coport-uni/SpinCoaterAutomation_I2C/claude_test/menu_cursor_check/runs/20261006_113356/frames/00_before.jpg

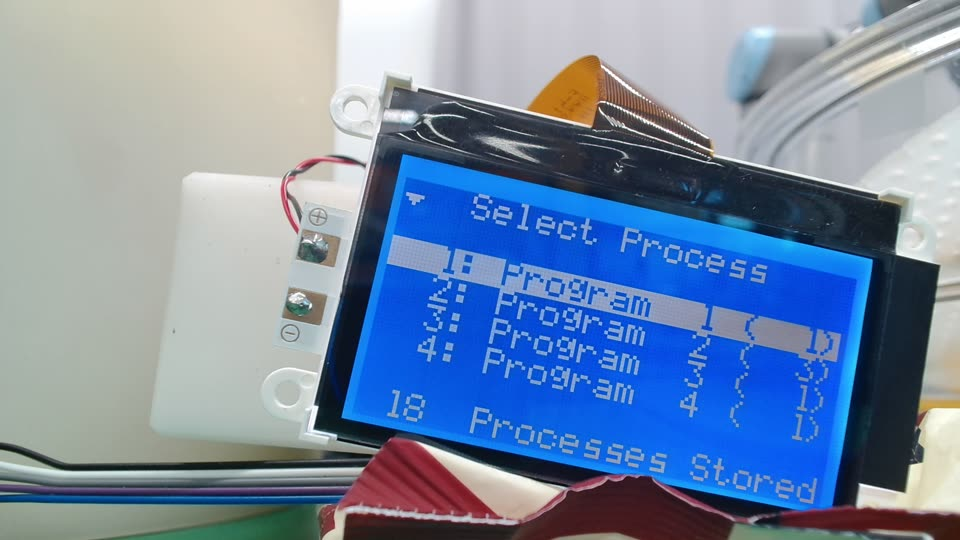
claude_test/menu_cursor_check/runs/20261006_113356/frames/00_before.jpg
