coport-uni/SpinCoaterAutomation_I2C/docs/ButtonLayout.jpg

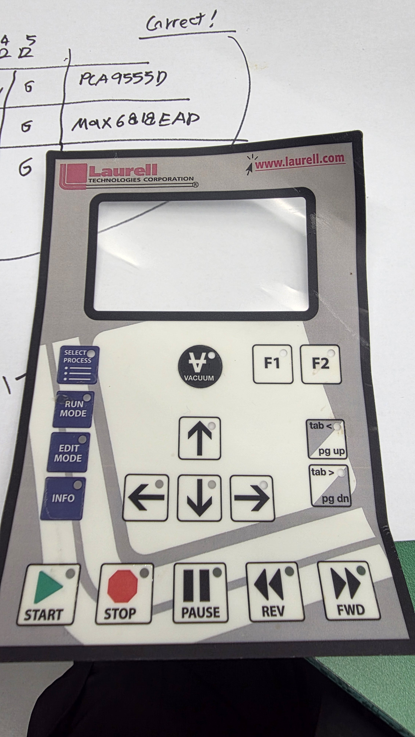
docs/ButtonLayout.jpg
