coport-uni/SpinCoaterAutomation_I2C/claude_test/KakaoTalk_20261006_142258731.jpg

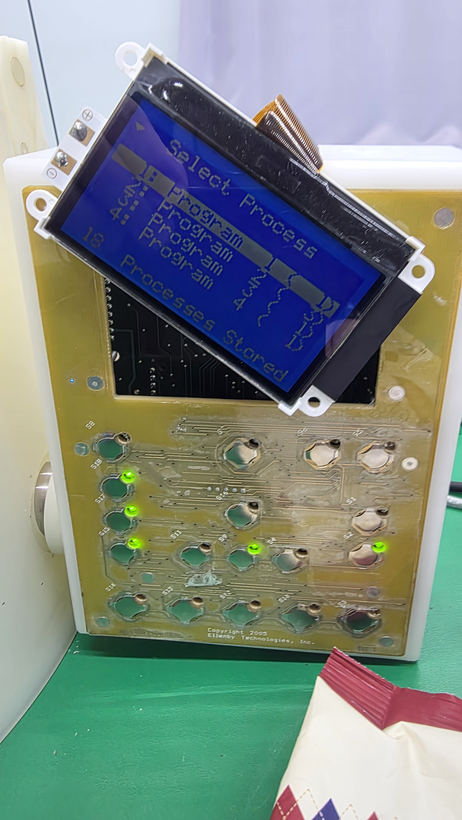
claude_test/KakaoTalk_20261006_142258731.jpg
