coport-uni/SpinCoaterAutomation_I2C/claude_test/lamp_trace/frames/00_before.jpg

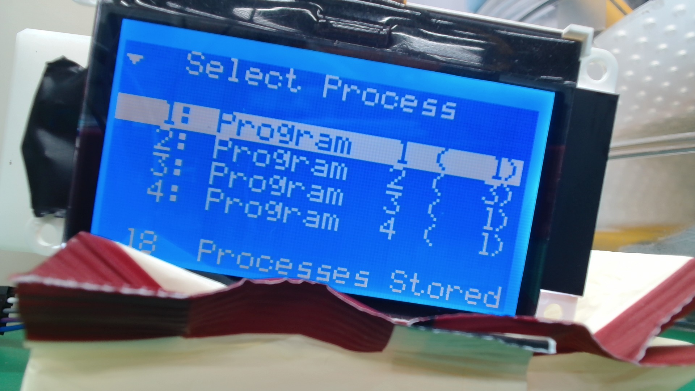
claude_test/lamp_trace/frames/00_before.jpg
