coport-uni/SpinCoaterAutomation_I2C/claude_test/led_only/invalid_run1_lcd.jpg

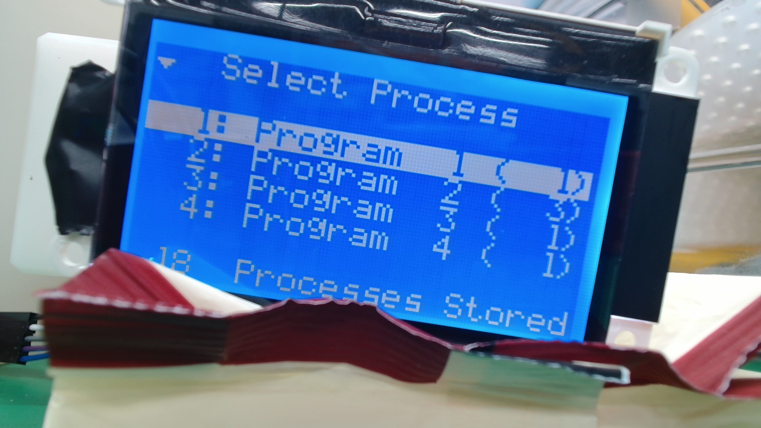
claude_test/led_only/invalid_run1_lcd.jpg
