coport-uni/SpinCoaterAutomation_I2C/claude_test/led_only/run3_lcd.jpg

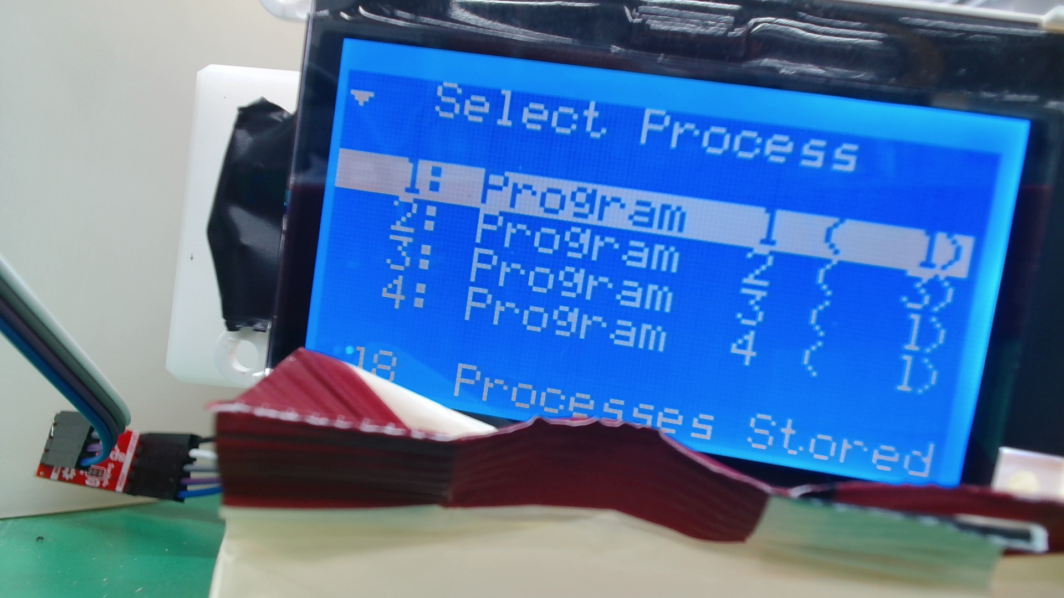
claude_test/led_only/run3_lcd.jpg
