coport-uni/SpinCoaterAutomation_I2C/claude_test/mk2_bench/frames/00_before.jpg

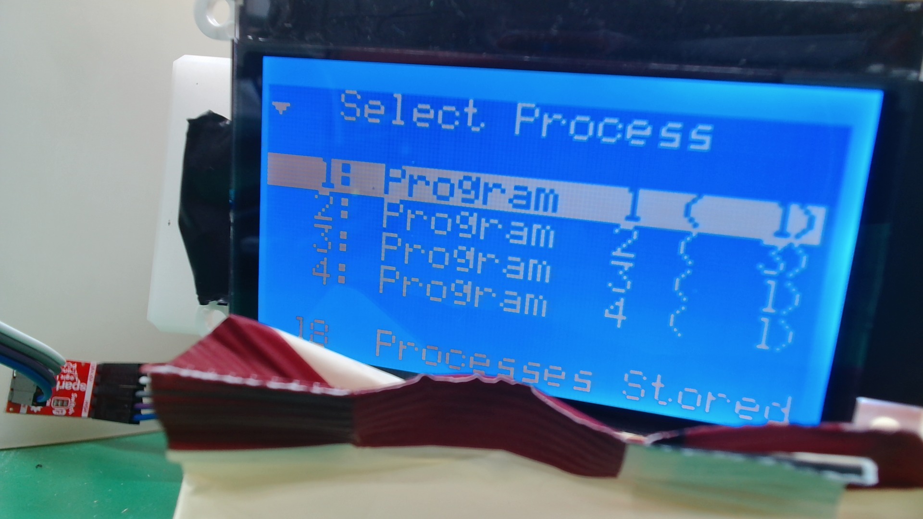
claude_test/mk2_bench/frames/00_before.jpg
