coport-uni/SpinCoaterAutomation_I2C/claude_test/mk2_bench/frames/01_after_DOWN.jpg

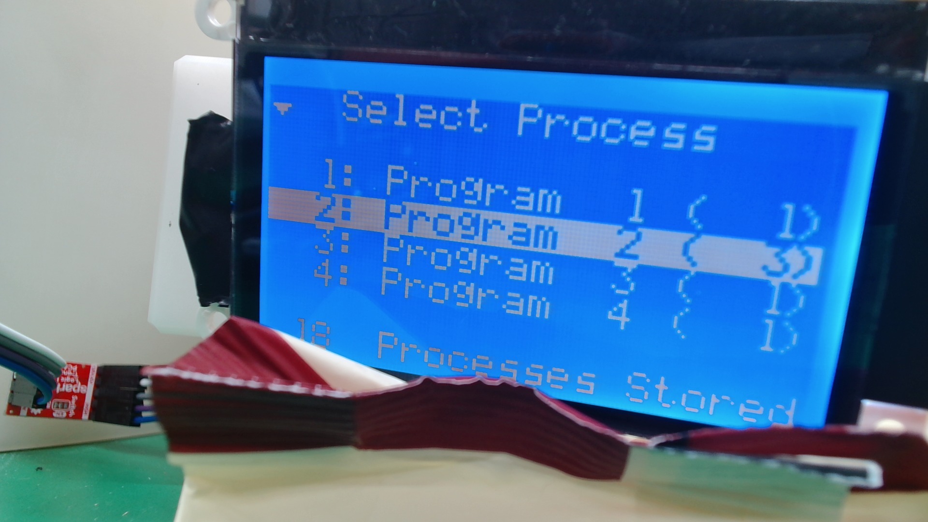
claude_test/mk2_bench/frames/01_after_DOWN.jpg
