coport-uni/SpinCoaterAutomation_I2C/(commit log)

2026-09-29 Map all 18 buttons and 16 LEDs of the keypad board
    Stage 1 of docs/spincoater_keypad_spec.md is complete. The keypad board
    was run standalone from the UNO Q 3.3 V rail and every button and LED
    was traced on real hardware.
    Findings:
    - Three slaves confirmed: PCA9555 at 0x21 and 0x22, PCA9532 at 0x60.
    - All 16 pins of 0x21 are buttons; 0x22 carries the other two.
    - PCA9532 channel n drives the LED of the button at 0x21 bit n, so
    button and LED share an index.
    - Header X1 pin 5 is INT, not RESET. It falls on any input change and
    returns high once the input register is read.
    - The 1 kOhm series resistor R16 on SCL does not break a 100 kHz bus.
    - The two LEDs the PCA9532 does not drive can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
    [i2c_scan.ino, keypad_probe.ino, pca9532_led.ino]
2026-09-29 feat(firmware): build the sketches for the R4 Minima too
    The spincoater mainboard I2C bus measured 5 V, so the 3.3 V UNO Q
    cannot be wired to it directly. Bench work moved to an UNO R4 Minima
    for a while, which needed both sketches to build for a board that has
    no Router Bridge.
    A HOST alias selected by ARDUINO_ARCH_ZEPHYR hides the difference: the
    UNO Q keeps talking through the Monitor object, every other board uses
    plain Serial over USB. host_begin() does the same for bring-up.
    i2c_scan also gained bus_check(), which samples SDA and SCL as plain
    GPIO before Wire takes the pins, in high impedance and again with the
    internal pull-up. That is what found the fault behind issue #3: the
    keypa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
    [bus_check.ino, i2c_scan.ino, pca9532_led.ino]
2026-09-29 chore(claude): adopt the CommonClaude harness
    Brings coport-uni/CommonClaude in as a submodule under external/ and
    wires its conventions and enforcement hooks into this repository, so
    that sessions follow one ruleset instead of an ad hoc one.
    The project CLAUDE.md imports the shared ruleset in full and then
    records the overrides this repository needs:
    - Arduino C++ conventions in place of the shared Python ones, keeping
    the 80-column limit, 4-space indent and Doxygen blocks.
    - Korean stays the language of prose documentation, since README.md,
    docs/ and claude_test/README.md are already written in it. Code
    comments, commit messages, issues and PRs stay English.
    - Ruff does not apply,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
2026-09-29 feat(claude_test): prove the UNO Q can act as an I2C target
    Spec section 8 carried "UNO Q Wire slave support unverified" as an open
    risk, and the whole stage 3 board choice hung on it. Two jumper wires
    settle it with no extra hardware.
    claude_test/slave_selftest opens Wire2 (i2c3, A4/A5) as a target at
    0x21 and drives the bus from Wire (i2c2, D20/D21) as a master, with
    A4 tied to D20 and A5 tied to D21. The keypad must be unplugged, since
    it answers at 0x21 itself; the scan line reports every address found so
    a stray 0x22 or 0x60 gives that away.
    The target answers its address, acknowledges a write, hands back the
    byte it was asked for, and fires both onReceive and onRequest. So the
    emulat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
2026-09-29 feat(claude_test): answer two I2C addresses from one controller
    Only two of the UNO Q's three I2C controllers reach the ordinary
    headers, and the emulator has to present three addresses: 0x21 and 0x22
    for the button expanders, 0x60 for the LED dimmer. The alternatives
    were breaking i2c4 out of the high density connector or dropping 0x60,
    and dropping 0x60 would cost the state feedback channel, since the
    mainboard's LED writes are what tell the host which keys are currently
    legal.
    Neither is necessary. The STM32 I2C peripheral has two own-address
    registers and the Zephyr driver mirrors them: struct i2c_stm32_data
    carries target_cfg and target2_cfg, the second behind
    CONFIG_I2C_STM32_V2, whic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
2026-09-29 test(claude_test): check both controllers hold two targets
    The previous run measured a pair of targets on i2c3 while i2c2 drove
    the bus, and the conclusion was stated as "two controllers times two
    addresses is four". That was arithmetic rather than a measurement:
    i2c2 had never been a target at all.
    TARGETS_ON_WIRE now picks which controller carries the pair, so both
    roles can be exercised. With the pair on i2c2 and i2c3 driving, the
    result matches: the driver accepts the second registration, both
    addresses answer, each serves its own byte, and both callback sets
    fire.
    A controller cannot test itself, because a master does not acknowledge
    its own target address. With two controllers one ha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
2026-09-30 docs: rewrite README in English with diagrams
    The shared CommonClaude rule requires English for every document,
    README included. The project CLAUDE.md overrode that to keep Korean
    prose documentation. The override is withdrawn, so the specification
    and claude_test/README are translated too and no tracked file carries
    Korean any more.
    README is rebuilt around figures rather than prose. Five Mermaid
    blocks carry the concept, the stage roadmap, the LED state-feedback
    loop, the UNO Q serial path and the controller-to-address allocation.
    Three hand-written SVGs under docs/diagrams carry the panel layout,
    the register map and the level shifter wiring, which are the three
    things position makes cle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
2026-10-06 feat(emu): emulate the keypad and move the menu cursor
    The keypad board is unplugged for good. firmware/pca9555_emu answers
    the mainboard as all three of its I2C devices: 0x21 and 0x22 on i2c2
    through the STM32's two own-address registers, 0x60 on i2c3, every one
    served by raw Zephyr target callbacks rather than the Arduino Wire
    wrapper. Wire reports a write only at STOP, so for the register write
    followed by a repeated-start read that a PCA9555 read uses, onRequest
    would fire before the register pointer had arrived.
    Key injection is restricted to the two arrow keys and the firmware
    refuses every other name in handle_line(), so START, STOP and VACUUM
    cannot be reached from the host protocol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
2026-10-06 feat(gui): add a virtual keypad driven by the mainboard's lamps
    With the keypad board gone there is no panel left to read, and the LED
    channel is the most useful thing on the bus: the mainboard lights a
    key's lamp only while that key is a legal input, so the lamps are a
    live list of the commands the machine will accept.
    claude_test/keypad_gui draws the 18 keys and lights them from two
    sources, the LEDS lines the emulator decodes out of the PCA9532 LS
    registers and the 0x22 output writes that carry EDIT MODE and RUN MODE.
    Only the arrows are clickable. Every other key is drawn greyed out, and
    the firmware refuses it by name as well, so a stray click cannot reach
    START, STOP or VACUUM.
    Co-A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
2026-10-06 refactor(gui): move the panel beside its sketch and document the pair
    firmware/pca9555_emu now holds both halves of the tool: the sketch and
    the Tk panel that drives it. A panel is useless apart from the sketch it
    talks to, so splitting them across firmware/ and claude_test/ only made
    the pair harder to find. Its README gives the run order and two Mermaid
    diagrams, one for where the pieces sit and one for how the Tk side is
    threaded.
    The panel is rewritten to the MIT convention: 80 columns, Google style
    docstrings on every public entry point, lower_case module constants.
    pyproject.toml pins Ruff to 80 columns, which CommonClaude section 6
    asks for and this repository never had, and waives t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
2026-10-06 feat(emu): serve all 18 keys, panel gated by the lamps
    NOT VERIFIED. Not compiled, not run on the bench. This branch is the
    parking spot CommonClaude section 5.1 rule 2 allows for work whose
    hardware step cannot happen yet, and section 12 forbids pushing or
    merging it in this state.
    pca9555_emu_gui.ino replaces the two key allowlist with a table of all
    18 keys from docs/button_map.json, adds a KEYS command that lists them,
    and tracks which expander a held key belongs to so 0x22 can be pressed
    as well as 0x21.
    keypad_gui.py enables a key only while its lamp is lit, so the spin
    coater's own state decides what may be pressed rather than a list
    written into the GUI. The gate is incomplete and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
    [keypad_gui.py, pca9555_emu_gui.ino]
2026-10-06 fix(emu): name the full panel build in its own boot banner
    The sketch still announced itself as pca9555_emu, so a log could not be
    told apart from the arrows-only build's. Renamed before the bench run so
    the captured output says what produced it.
    Bench run 2026-10-06, operator present, spin coater powered off for the
    flash and on for the run. All three addresses registered rc=0, the
    mainboard booted normally and polled 0x21 at the usual 50 ms, KEYS
    listed all 18 names, and both rejection paths answered ERR: an unknown
    key name, and a hold time outside 20..1000 ms. The arrows drove the
    right bits and walked the Select Process cursor, confirmed on camera.
    The other 16 keys are not exercised.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
    [pca9555_emu_gui.ino]
2026-10-06 fix(emu): time key release and report all lamps
    Three changes to pca9555_emu_gui.ino, committed together because this
    exact file is the build that ran on the bench.
    Key release (#19). A PRESS was released from the top of loop(), so a
    busy log stretched a 120 ms hold to 2.7 s. A k_timer now restores the
    bit on time and loop() only reports it.
    Lamp lines (#16). LED22 reports 0x22 port 1, output and configuration,
    on every write and from STATE, so a panel opened late still sees EDIT
    and RUN. LEDS now carries PSC0/PWM0/PSC1/PWM1, because a channel on a
    0 % PWM is dark and the mainboard writes PWM0 = 0x00 at boot.
    Bus diagnostics (#18). TRACE ON logs every target callback, HUSH <s>
    holds all o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
    [pca9555_emu_gui.ino]
2026-10-06 feat(gui): follow every lamp, overlay key layout
    The panel reads EDIT MODE and RUN MODE from the new LED22 line, lit
    only when the bit is an output driven low, and draws a PWM channel dark
    while its duty register is 0x00 (#16). Keys now sit where they sit on
    the real overlay, docs/ButtonLayout.jpg (#17).
    Ruff check and format pass. The lamp parsing was run offline against
    the new line formats, and the panel was opened against the live
    emulator on 2026-10-06 with the spin coater on Select Process. The
    operator's only remark was that the down arrow and tab/pg dn lamps
    should be lit, as on the real keypad; they are dark because the
    emulator never receives LS0 and LS2 (#18), not because of the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
2026-10-06 test(bench): record lamp traces and key release
    Logs and LCD frames from the 2026-10-06 bench runs, indexed in
    claude_test/README.md: the photo of the real keypad's five lit lamps,
    the TRACE/HUSH captures that show LS2 and LS0 arriving without their
    data byte and the 0x21 port-0 read never arriving, the PGDN and
    DOWN/UP key tests, and the timer-release run.
    Refs #18
    Refs #19
2026-10-06 docs(todo): add sections 14 to 17
    Lamp read-back (#16), overlay layout (#17), the missing LS0/LS2 writes
    (#18) and the timer-driven key release (#19), with progress ticked.
2026-10-06 test(bench): isolate the keypad bus on one controller
    claude_test/led_only serves 0x21 and 0x60 from i2c2 alone, with i2c3
    unused and the A4/A5 jumpers pulled, and records every target callback
    silently for 180 s.
    Run on the UNO Q with the spin coater, operator present, 2026-10-06,
    no key pressed. Run 3 (rc21=0 rc60=0, 2024 events, none dropped) shows
    the same losses as the full emulator: LS2 and LS0 arrive as a command
    byte and a STOP, and the 0x21 read after [00] never arrives. The
    second controller is therefore not the cause. In every log so far the
    follow-up is lost after an even command byte and arrives after an odd
    one.
    Runs 1 and 2, kept as invalid_run*, had the jumpers in by mistak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
2026-10-06 docs(todo): add the single-controller isolation test
    Section 18, under #18, all items ticked: probe written, compiled, run
    on the bench, compared with the earlier trace, and the emulator and
    jumpers restored afterwards.
2026-10-06 docs: record the even-command-byte transfer loss
    Earlier documents said the mainboard never writes LS0 or LS2. The
    2026-10-06 raw traces show it writes all four selectors; the emulator
    loses every transfer that follows an even command byte, on any address
    and with a single controller. Correct the README, led_map.json, the
    spec, the panel README and its docstring, and describe the open fault,
    the Wire2 requirement and the timer-driven key release.
    Refs #18, closes #20
    [keypad_gui.py]
2026-10-06 test(bench): find the target SDADEL behind lost reads
    Add claude_test/ack_timing, which serves the three keypad addresses
    without pressing a key, counts per command byte whether the follow-up
    arrived, and changes TIMINGR at run time. Run 2026-10-06 with the
    operator present: SDADEL 11 to 13 (default 12) lose every follow-up,
    SDADEL 0 to 7 lose none. With SDADEL 4 on both controllers and the
    spin coater power-cycled, nothing was lost in four minutes and LS2 and
    LS0 arrived with data. Logs are kept beside the probe.
    Refs #18, #21
2026-10-06 feat(emu): add pca9555_emu_gui_mk2 with SDADEL fix
    Copy pca9555_emu_gui and set the I2C targets' SDADEL to 4 on both
    controllers after registration, since the driver's 400 kHz default of
    12 makes the mainboard read a NACK after every even command byte. The
    value is written only with the peripheral off and the bus idle,
    reported in TIMING lines, and re-checked once a second.
    Bench 2026-10-06, operator present: LS2 and LS0 arrive at power-on,
    the Select Process lamps match the real keypad, and DOWN, UP and the
    port-0 key PGDN move the LCD on camera. Logs in claude_test/mk2_bench.
    Refs #18, #21, closes #22
    [keypad_gui.py, pca9555_emu_gui_mk2.ino]
2026-10-06 docs: mark the lost-transfer fault fixed by mk2
    Retitle the README fault section as fixed and point its links there,
    direct readers of pca9555_emu_gui to mk2, and record the cause and the
    fix in led_map.json. Add ToDo section 22.
    Refs #18, closes #23
